msingh-0007/SKY_130_LIA/PVT_AND_MONTE_CARLO_DATA/BMR_TT_MONTE_CARLO_DIFF.PNG

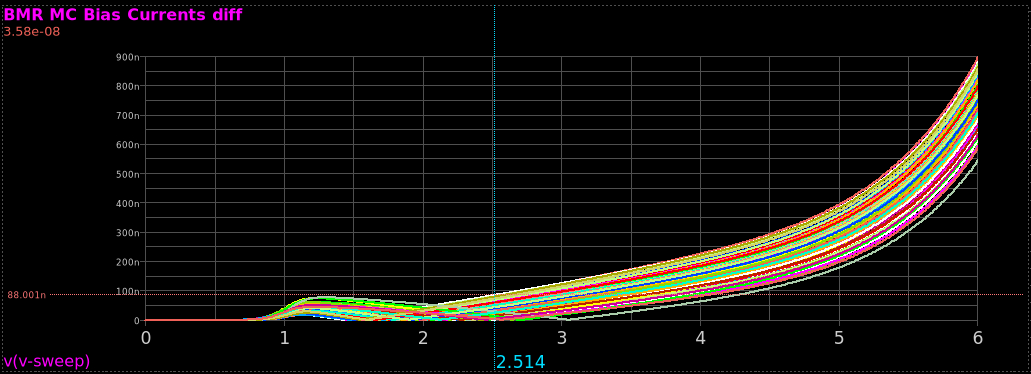
PVT_AND_MONTE_CARLO_DATA/BMR_TT_MONTE_CARLO_DIFF.PNG
