msingh-0007/SKY_130_LIA/PVT_AND_MONTE_CARLO_DATA/LPF_W_TT_MM.PNG

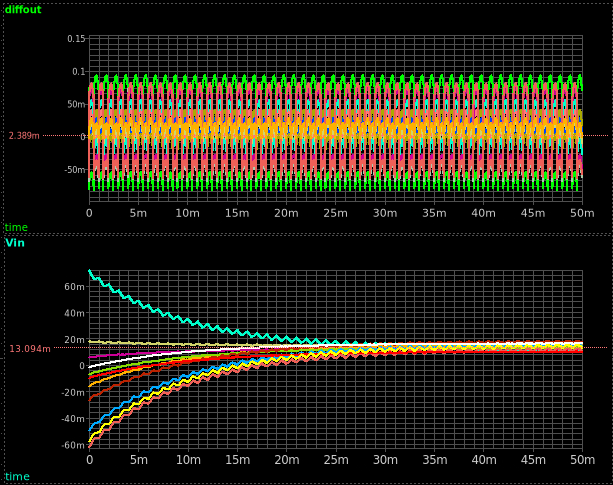
PVT_AND_MONTE_CARLO_DATA/LPF_W_TT_MM.PNG
