msingh-0007/SKY_130_LIA/SCHEMATIC_CIRCUITS/4-SWITCH_MIXER.PNG

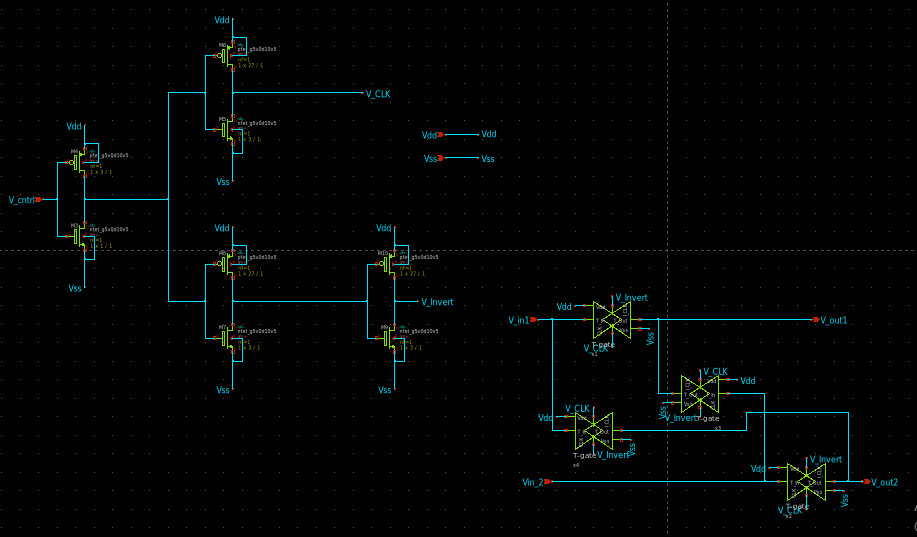
SCHEMATIC_CIRCUITS/4-SWITCH_MIXER.PNG
