msingh-0007/SKY_130_LIA/SCHEMATIC_CIRCUITS/BETA_MULTIPLIER_REFERENCE.PNG

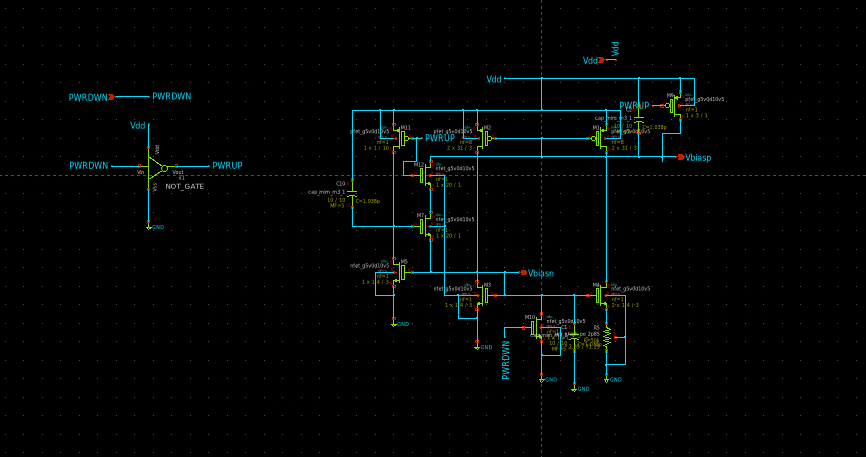
SCHEMATIC_CIRCUITS/BETA_MULTIPLIER_REFERENCE.PNG
