msingh-0007/SKY_130_LIA/SCHEMATIC_CIRCUITS/COMMON_MODE_FEEDBACK_AMPLIFIER.PNG

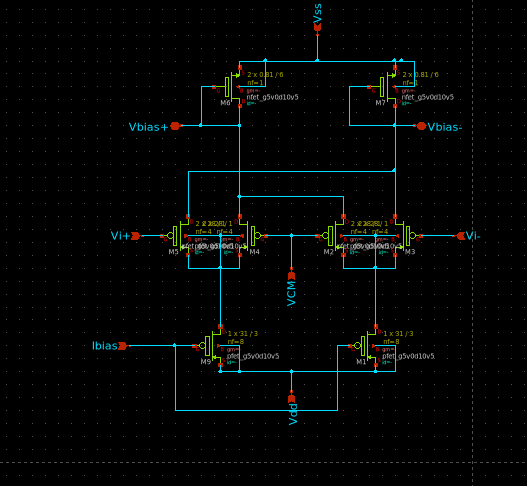
SCHEMATIC_CIRCUITS/COMMON_MODE_FEEDBACK_AMPLIFIER.PNG
