msingh-0007/SKY_130_LIA/SCHEMATIC_CIRCUITS/CURRENT_STEERING_OTA.PNG

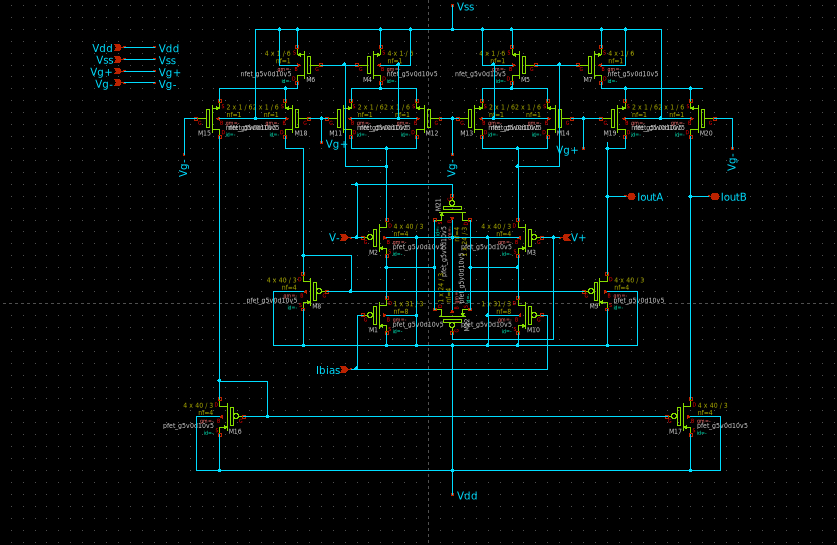
SCHEMATIC_CIRCUITS/CURRENT_STEERING_OTA.PNG
