msingh-0007/SKY_130_LIA/SCHEMATIC_CIRCUITS/FDA_OP_AMP.PNG

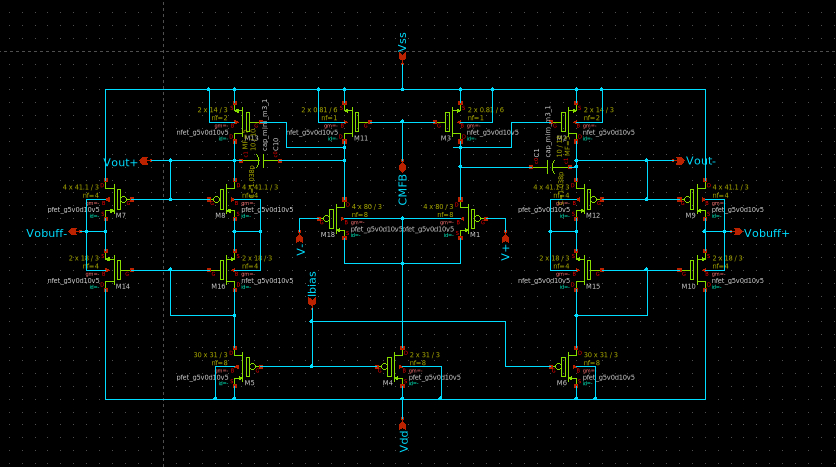
SCHEMATIC_CIRCUITS/FDA_OP_AMP.PNG
