msingh-0007/SKY_130_LIA/SCHEMATIC_CIRCUITS/LOCK_IN_AMPLIFIER_SCHEMATIC.PNG

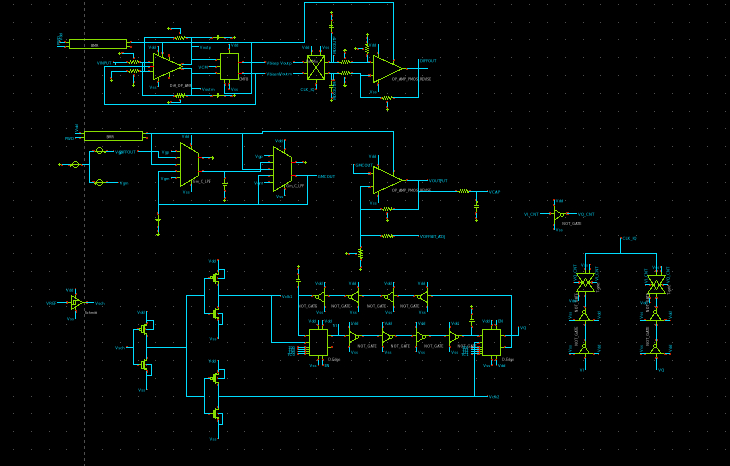
SCHEMATIC_CIRCUITS/LOCK_IN_AMPLIFIER_SCHEMATIC.PNG
