msingh-0007/SKY_130_LIA/SCHEMATIC_CIRCUITS/OP_AMP.PNG

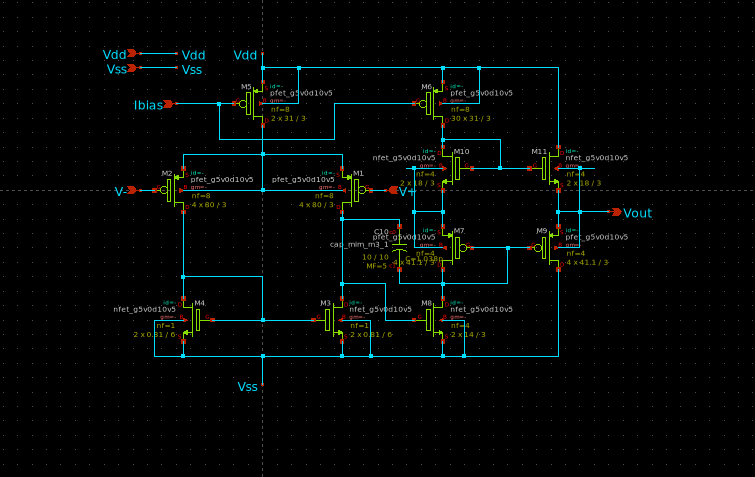
SCHEMATIC_CIRCUITS/OP_AMP.PNG
