msingh-0007/SKY_130_LIA/SCHEMATIC_CIRCUITS/SCHMITT_TRIGGER.PNG

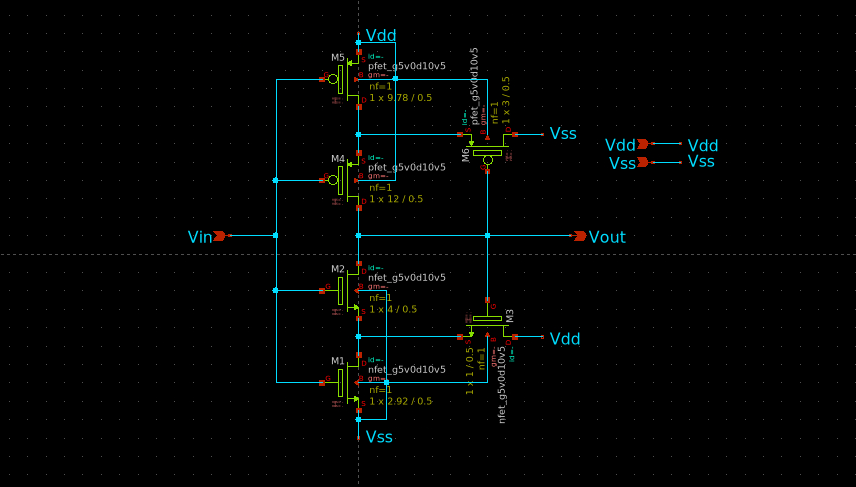
SCHEMATIC_CIRCUITS/SCHMITT_TRIGGER.PNG
