msingh-0007/SKY_130_LIA/SCHEMATIC_CIRCUITS/T-GATE-FF.PNG

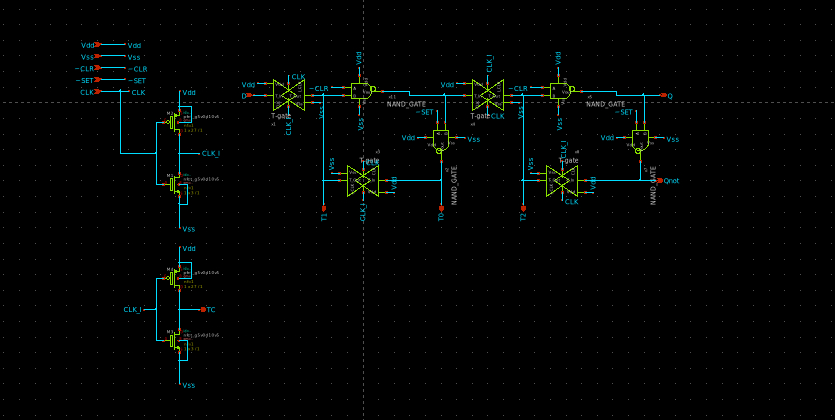
SCHEMATIC_CIRCUITS/T-GATE-FF.PNG
