msingh-0007/SKY_130_LIA/SCHEMATIC_CIRCUITS/T-GATE.PNG

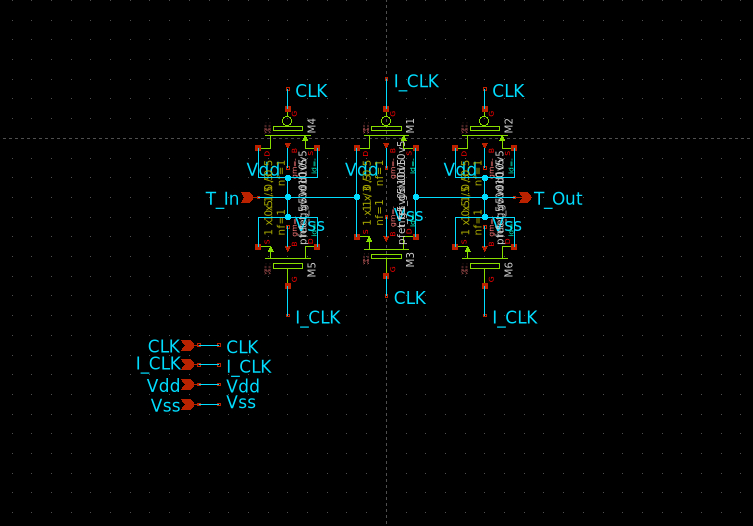
SCHEMATIC_CIRCUITS/T-GATE.PNG
