msingh-0007/SKY_130_LIA/SCHEMATIC_DATA/GM_C_LPF_CUTOFF_TT_UPDATE_VGC04.PNG

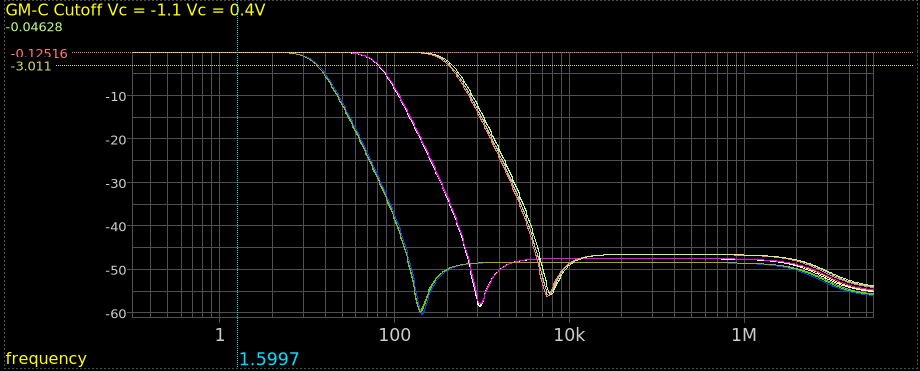
SCHEMATIC_DATA/GM_C_LPF_CUTOFF_TT_UPDATE_VGC04.PNG
