msingh-0007/SKY_130_LIA/SCHEMATIC_DATA/GM_C_LPF_TRANSCONDUCTANCE.PNG

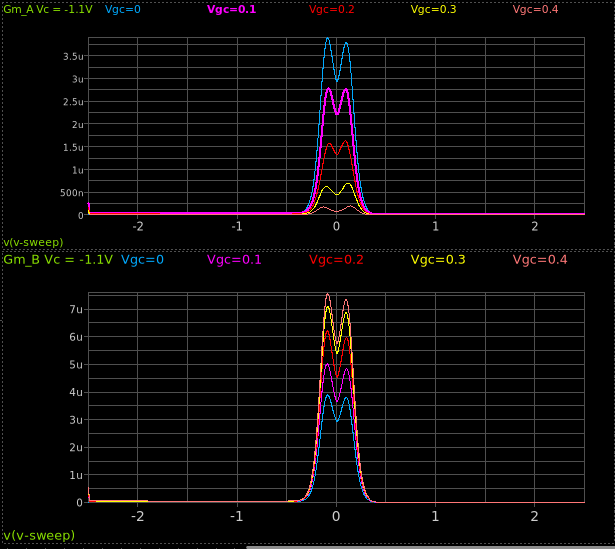
SCHEMATIC_DATA/GM_C_LPF_TRANSCONDUCTANCE.PNG
