msingh-0007/SKY_130_LIA/SCHEMATIC_DATA/GM_C_LPF_UPDATE_TRANSIENTS_TT.PNG

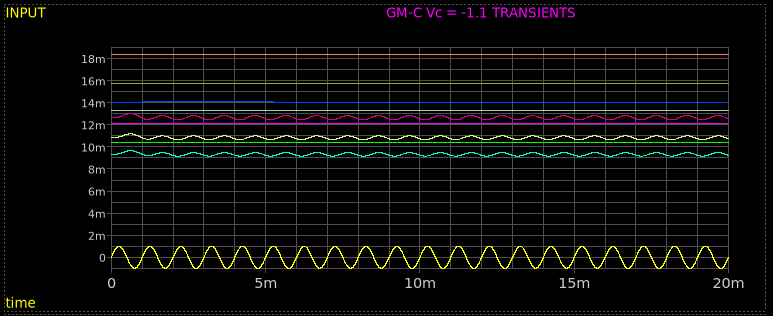
SCHEMATIC_DATA/GM_C_LPF_UPDATE_TRANSIENTS_TT.PNG
