msingh-0007/SKY_130_LIA/SCHEMATIC_DATA/LOCK_IN_AMPLIFIER_FINAL_FILTERED_OUTPUT_10U_1S.PNG

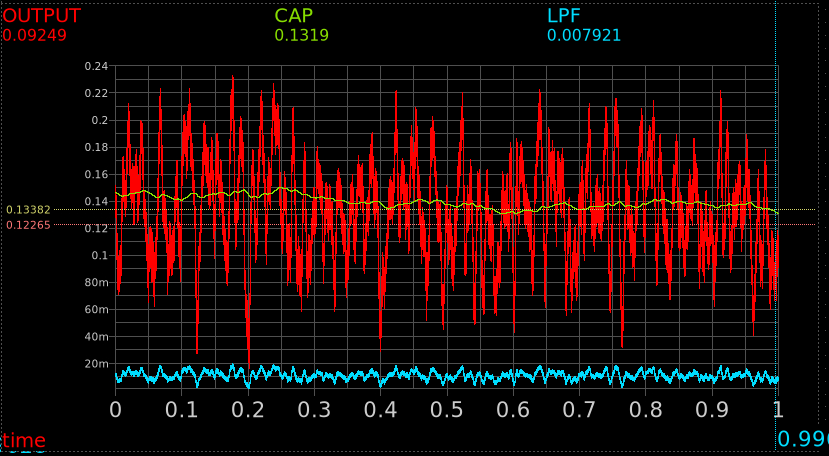
SCHEMATIC_DATA/LOCK_IN_AMPLIFIER_FINAL_FILTERED_OUTPUT_10U_1S.PNG
