msingh-0007/SKY_130_LIA/SCHEMATIC_DATA/LOCK_IN_WAVEFORMS_1MV_baseline.PNG

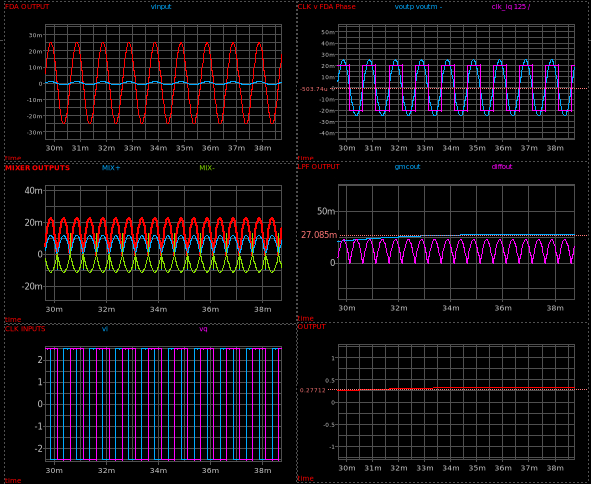
SCHEMATIC_DATA/LOCK_IN_WAVEFORMS_1MV_baseline.PNG
