msingh-0007/SKY_130_LIA/SCHEMATIC_DATA/LOCK_IN_WAVEFORMS_1mv_BASLINE_DIFFOUT_UPPER.PNG

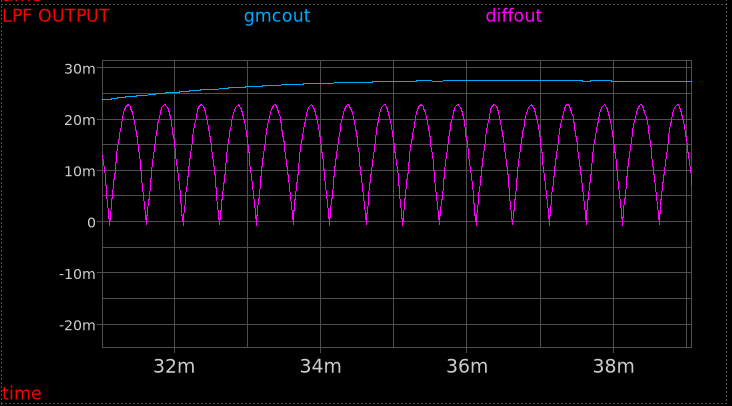
SCHEMATIC_DATA/LOCK_IN_WAVEFORMS_1mv_BASLINE_DIFFOUT_UPPER.PNG
