msingh-0007/SKY_130_LIA/SCHEMATIC_DATA/LOCK_IN_WAVEFORMS_1mv_NOISY_10mv_WHITE_TOTAL_OUTPUT_PT2_UPDATE.PNG

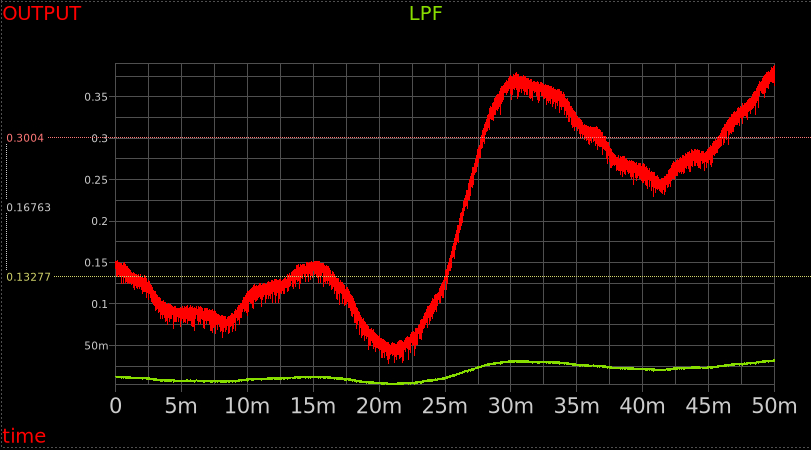
SCHEMATIC_DATA/LOCK_IN_WAVEFORMS_1mv_NOISY_10mv_WHITE_TOTAL_OUTPUT_PT2_UPDATE.PNG
