msingh-0007/SKY_130_LIA/SCHEMATIC_DATA/LOCK_IN_WAVEFORMS_1mv_NOISY_FFT_MIXED_OUTPUT_HARMONIC_UPDATE.PNG

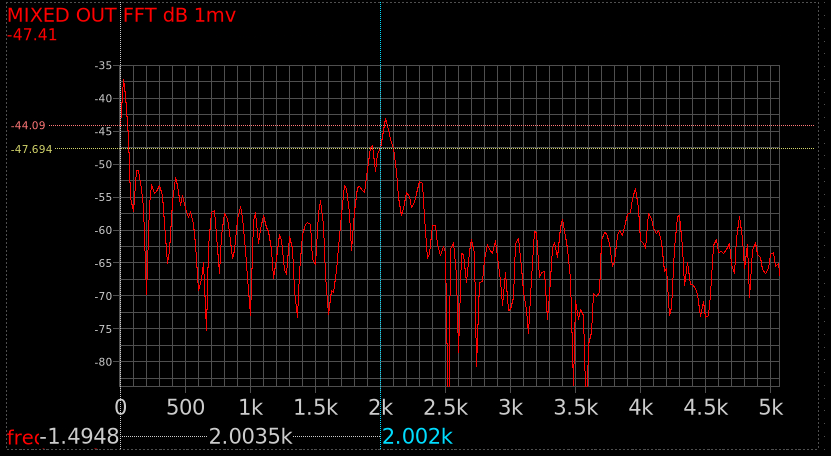
SCHEMATIC_DATA/LOCK_IN_WAVEFORMS_1mv_NOISY_FFT_MIXED_OUTPUT_HARMONIC_UPDATE.PNG
