msingh-0007/SKY_130_LIA/SCHEMATIC_DATA/LOCK_IN_WAVEFORMS_10uv_NOISY_10mv_60Hz_10Hz_0.4_WHITE_TOTAL_OUTPUT_PT4_UPDATE.PNG

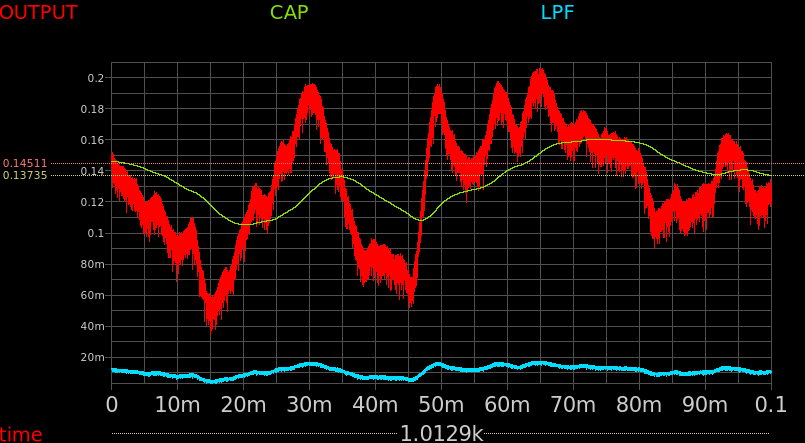
SCHEMATIC_DATA/LOCK_IN_WAVEFORMS_10uv_NOISY_10mv_60Hz_10Hz_0.4_WHITE_TOTAL_OUTPUT_PT4_UPDATE.PNG
