msingh-0007/SKY_130_LIA/SCHEMATIC_DATA/LOCK_IN_WAVEFORMS_10uv_NOISY_10mv_WHITE_GMC_OUTPUT_UPDATE.PNG

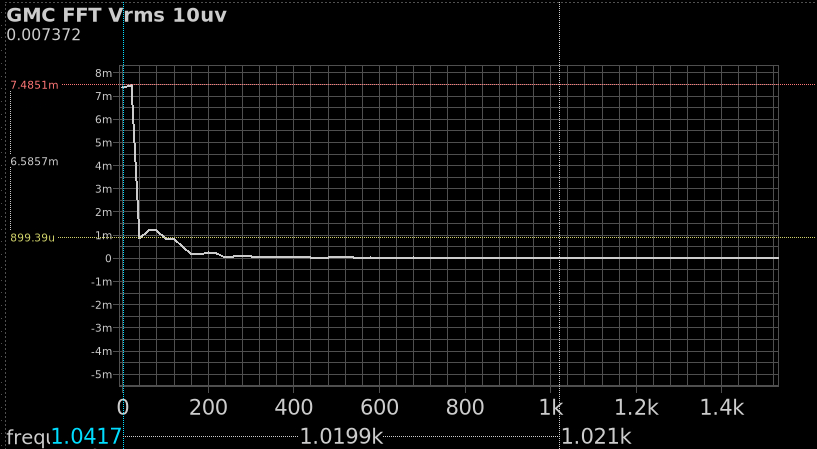
SCHEMATIC_DATA/LOCK_IN_WAVEFORMS_10uv_NOISY_10mv_WHITE_GMC_OUTPUT_UPDATE.PNG
