msingh-0007/SKY_130_LIA/SCHEMATIC_DATA/LOCK_IN_WAVEFORMS_10uv_WHITE_NOISY_AMPLIFIED_INPUT_UPDATE.PNG

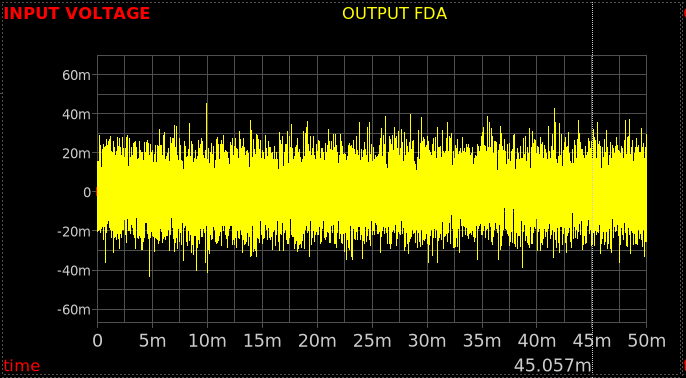
SCHEMATIC_DATA/LOCK_IN_WAVEFORMS_10uv_WHITE_NOISY_AMPLIFIED_INPUT_UPDATE.PNG
