msingh-0007/SKY_130_LIA/SCHEMATIC_DATA/OP_AMP_FINALLY_OPERATING_POINT_CLOSED_LOOP.PNG

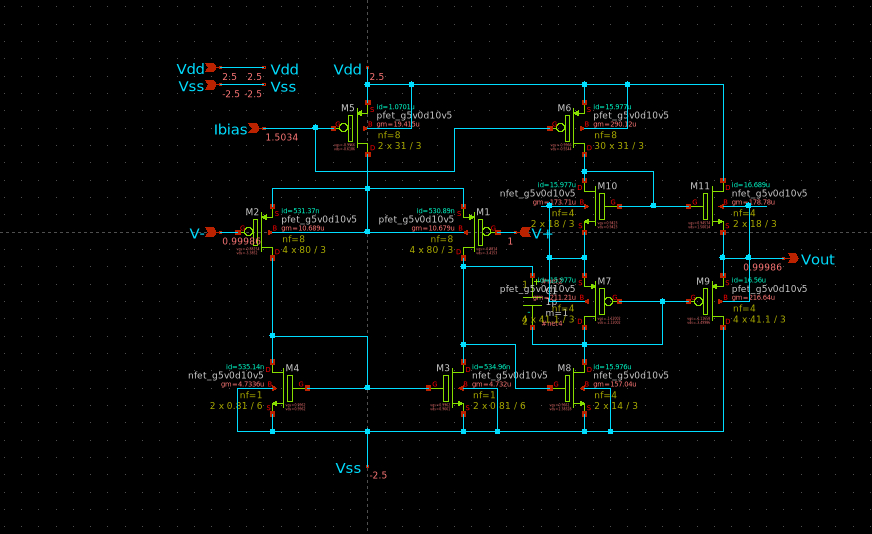
SCHEMATIC_DATA/OP_AMP_FINALLY_OPERATING_POINT_CLOSED_LOOP.PNG
